sloev/kaffeautomat/examples/kaffeautomat/mekanik.pdf

Byggeprojekt

# Kaffeautomaten

## Poser i tekstil-hængekøjer, én stålwire og en lidt skrå rampe

Idéen
Én wire holder alle poserne.

## Spoles wiren op, slipper den poserne én ad gangen, nedefra. Hver

pose glider ned ad en lidt skrå rampe og lander blødt i udtaget.

# Opbygningen set forfra

Motor + spole vikler wiren op

Stålwiren hænger skjult bag væggen

Syet løkke gennem slidsen, låst af wiren

Tekstil-hængekøje, skruet fast i venstre side

Wiren spoles op forbi den nederste løkke

Løkken slipper, og gjorden folder sig ud

Posen falder ned på rampen

# Hængekøjen: posen står i en gjord

1

## Fast ende

Gjorden foldes dobbelt og
skrues i væggen med en skrue og en stor skive, så stoffet ikke rives over.

2

## Posen står i U'en

Gjorden bærer posen i siderne og under bunden. Væggen
hælder 5–10° bagover, så posen læner sig ind mod den.

3

## Løkke i slidsen

Den anden ende går gennem
en slids. Bag væggen er der syet en lille løkke, som wiren går igennem.

Materiale: nylon- eller polyestergjord, 25–50 mm bred. Smelt de klippede kanter, så de ikke flosser.

# Ét salg, trin for trin

1

Motor starter

Spolen begynder at
vikle wiren op.

2

Wire glider op

Wirens ende passerer
den nederste løkke.

3

Løkke slipper

Løkken smutter ind
gennem slidsen, og
gjorden folder ud.

4

Pose falder

Den lander på rampen
og glider frem til
udtaget.

5

Motor stopper

Posen trykker
vippepladen ned, og
kontakten slukker
motoren.

# Den lidt skrå rampe, set fra siden

Motor og wire bag væggen

Poserne hænger i hængekøjer

Tekstil-trampolin tager faldet

Glat rampe, cirka 20–30°

Skum + vippeplade med stopkontakt

# Sådan lander posen blødt

20–30°

Rampens hældning: stejl nok til at posen glider, flad nok til at den ikke får for meget fart. Det afhænger af overfladen, så test med en pose ris.

## Trampolin af gjord

Et stykke stof spændt skråt under søjlen tager imod posen og bremser faldet.

## Glid i stedet for smæk

Rampen gør faldet til en glidebevægelse, så posen aldrig lander lodret på et hjørne.

## Blødt stop

En skumplade mod forkanten tager det sidste stød og dæmper larmen.

# Kræfterne er små

~5 N

Hver ende af gjorden bærer cirka halvdelen af en pose på 1 kg.

1–2 N

Friktion pr. løkke, når wiren trækkes op gennem den.

15–20 N

Samlet træk med ti poser. En lille 12 V gearmotor klarer det let.

# Stykliste

Del | Forslag | Note
Gjord | Nylon eller polyester, 25–50 mm | Smelt kanterne
Stålwire | Rustfri, 1–1,5 mm | Glat ende uden knude
Motor | 12 V gearmotor, 10–30 rpm | Lille spole på akslen
Stopkontakt | Mikrokontakt + vippeplade | Posen rammer pladen, ikke kontakten
Væg | Krydsfiner, 9 mm eller mere | Glatte slidser, skiver ved skruer
Rampe | Glat plade, f.eks. laminat | Hældning 20–30°
Landing | Gjord-trampolin + skumplade | Dæmper stød og larm

# Genopfyldning, oppefra og ned

1 | Kør motoren baglæns, eller rul wiren af med hånden, så dens ende hænger lige over den øverste slids.
2 | Stik den øverste løkke gennem slidsen, sænk wiren ned gennem den, og stil posen i hængekøjen.
3 | Gentag nedad, én pose ad gangen, til wiren går gennem den nederste løkke.
4 | Luk lågen. Maskinen er klar til næste salg.

# Test før du bygger færdigt

## Ris i stedet for kaffe

Test fald, trampolin og rampe med en pose ris på 1 kg.

## Et døgn med fuld vægt

Lad en fuld pose hænge i gjorden. Se om sømme og løkke holder.

## Løkke og slids

Løkken skal kun lige være stor nok til wiren, så den ikke hænger fast i slidsen.

## Glat wire-ende

Ingen knude eller flosset ende, så wiren glider rent ud af løkkerne.

Næste skridt
Byg én søjle med tre poser.

## Få wire, løkker og rampe til at virke i lille skala, før hele maskinen

bygges.
