sloev/kaffeautomat/(commit log)

2026-10-06 Tilføj mekanik-PDF og design for MobilePay-betaling
    PDF med mekanikken, designdokument for betaling uden abonnement
    (MobilePay MyShop -> Android-notifikation -> Arduino), Arduino-sketch
    til motor/stopkontakt og Kotlin-skelet til notifikationslæseren.
    Claude-Session: https://claude.ai/code/session_01HHYw73mMGBmzsFeQESTBqa
2026-10-06 Generalisér til automat for alle varer; kamera-klip og statusvindue
    - Android-app som rigtigt Gradle-projekt (dk.automat): notifikationslytter,
    vare-valg ud fra beløb, dedup, lager, kø, USB-serial til motorstyring,
    sort skærm med lille konfigurerbart statusvindue til plexiglas,
    videoklip af kunden pr. køb (uden lyd, auto-sletning), salg.csv,
    ntfy-beskeder til ejeren og ejer-menu.
    - Alt automat-specifikt i config.json; eksempler for kaffe, æg og test.
    - Firmware med flere søjler: DISPENSE <n>, REWIND <n> <ms>, SLOTS.
    - docs/design.md erstatter docs/betaling.md.
    Claude-Session: https://claude.ai/code/session_01HHYw73mMGBmz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
2026-10-07 Cloudflare Worker server with provisioning; prepare repo for public
    - worker/: Cloudflare Worker + D1 replaces the Python reference server.
    Owner login (Worker secrets) provisions automats from the example
    configs, creates admins (PBKDF2) and assigns them to automats.
    Phones pair with a one-time QR code; config is edited in the dashboard
    and pushed via heartbeat when the phone's version is behind.
    Free-plan friendly: static dashboard served from edge cache, heartbeat
    usually writes nothing, cron for offline alerts and event pruning.
    - Android: QR pairing (ScanActivity) and manual code entry, server.json,
    config versioning; removed setConfig command.
    - examples/: kaffeautomat (c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
    [Machine.kt]
